NinoRataDeCMasMas/Controlador-de-velocidad-para-motor-DC/(list of files, drawings)

Other design files:
schematics/schematic.fzz
